Sofronio/SofronioPourOverRatioScale/WireConnection.jpg

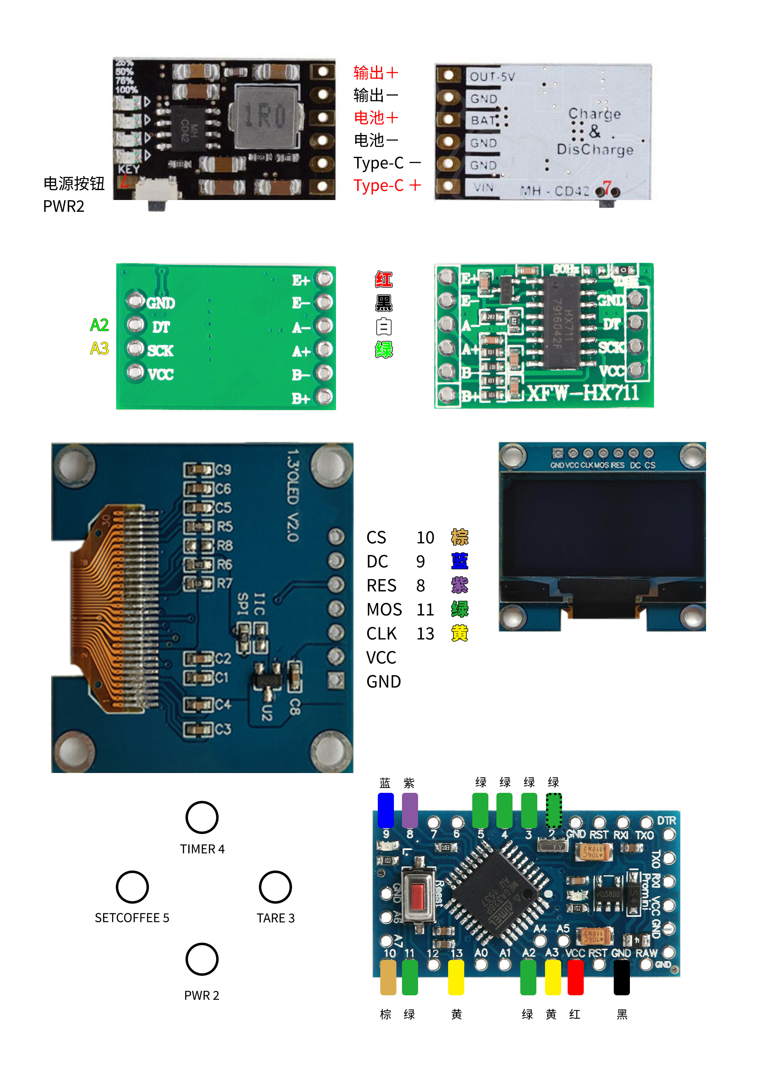
WireConnection.jpg
